jflitton/the-c128-keyboard-project/pcb/bom.csv

Reference | Qty | Value | DNP | Exclude from BOM | Exclude from Board | Footprint | Datasheet
C1,C2,C3 | 3 | 220 pF |  |  |  | Capacitor_SMD:C_0603_1608Metric_Pad1.08x0.95mm_HandSolder | ~
R1,R2,R3 | 3 | 330 |  |  |  | Resistor_SMD:R_0603_1608Metric_Pad0.98x0.95mm_HandSolder | ~
U1,U2,U3 | 3 | MAX16054 |  |  |  | Package_TO_SOT_SMD:TSOT-23-6 | https://datasheets.maximintegrated.com/en/ds/MAX16054.pdf
U4 | 1 | 74AUC1G66 |  |  |  | Package_SO:TSOP-5_1.65x3.05mm_P0.95mm | http://www.ti.com/lit/ds/symlink/sn74auc1g66.pdf
