jflitton/the-c128-keyboard-project/plate/plate.step

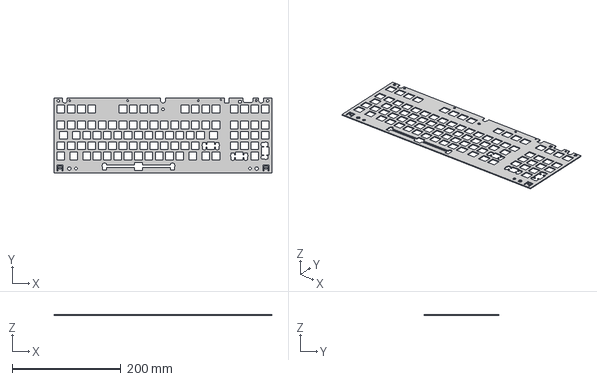
[picture p1: CAD file, 2025-11-16]
plate/plate.step
401.5 x 137.8 x 1.50 mm
