jflitton/the-c128-keyboard-project/printable_parts/128D/adapter_mitsumi_costar_spacebar_to_cherry_stabilizer.stl

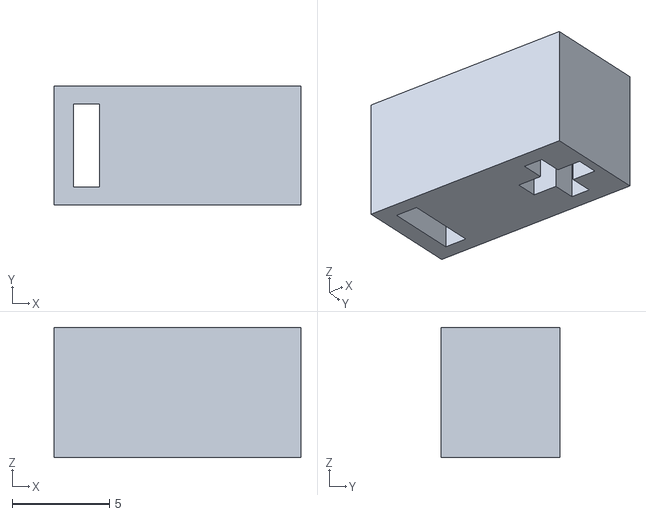
[picture p2: CAD file, 2025-11-24]
printable_parts/128D/adapter_mitsumi_costar_spacebar_to_cherry_stabilizer.stl
12.7 x 6.10 x 6.70
