jflitton/the-c128-keyboard-project/printable_parts/adapter_mitsumi_spacebar_to_cherry_stabilizer.stl

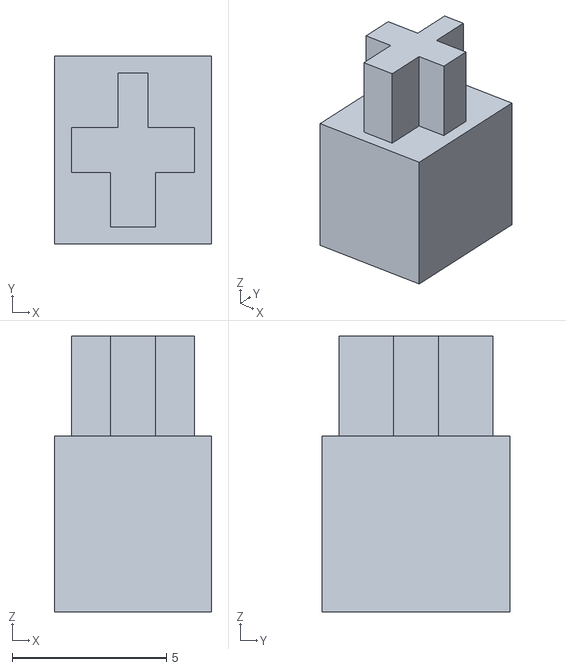
[picture p3: CAD file, 2025-11-17]
printable_parts/adapter_mitsumi_spacebar_to_cherry_stabilizer.stl
5.10 x 6.10 x 8.95
