jflitton/the-c128-keyboard-project/printable_parts/spacers_external_enclosure.stl

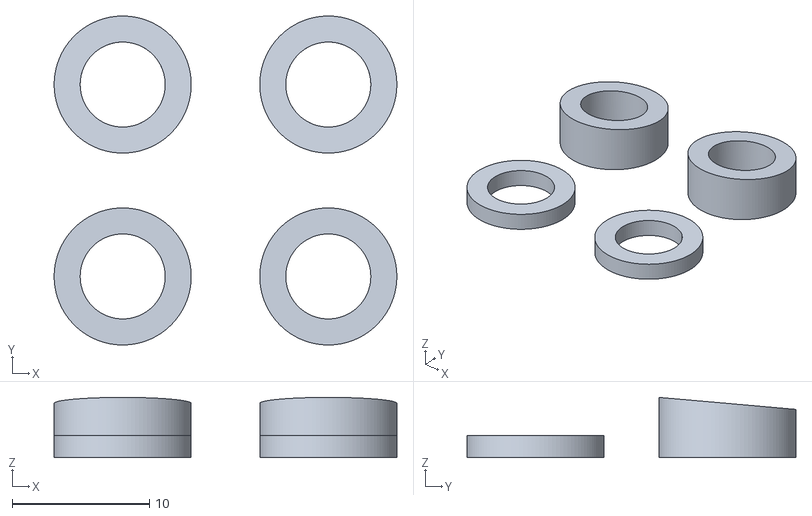
[picture p4: CAD file, 2025-11-16]
printable_parts/spacers_external_enclosure.stl
25.0 x 24.0 x 4.39
