jflitton/the-c128-keyboard-project/printable_parts/widget_foam_cutter_handle.stl

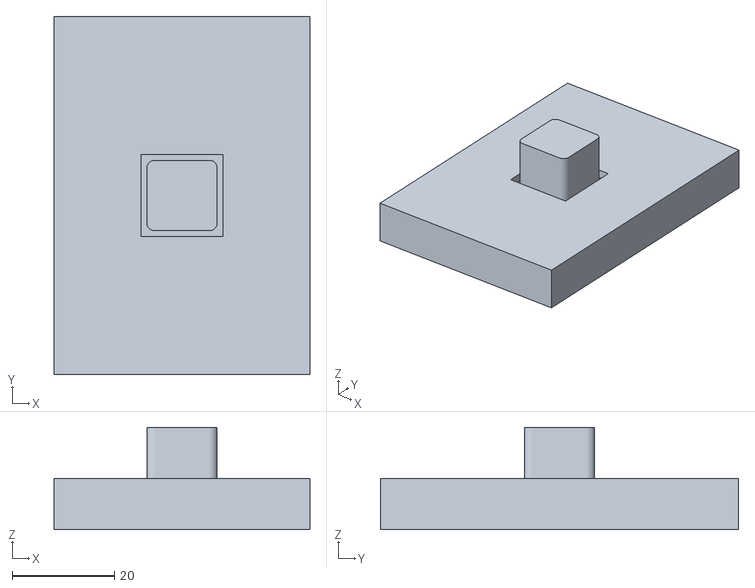
[picture p5: CAD file, 2025-11-09]
printable_parts/widget_foam_cutter_handle.stl
50.0 x 70.0 x 20.0
