jflitton/the-c128-keyboard-project/printable_parts/connector_motherboard_side.stl

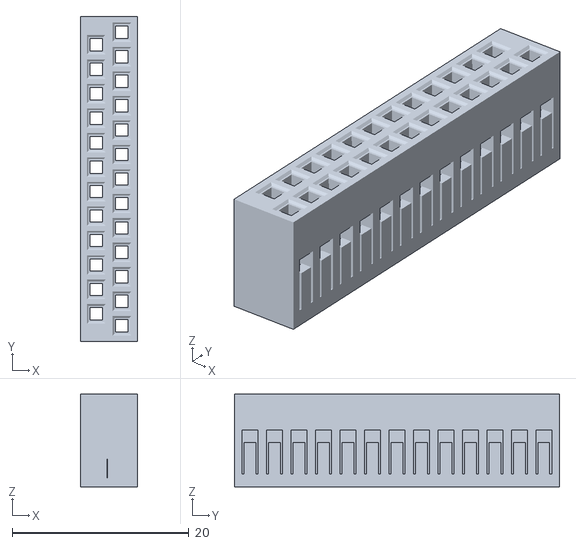
[picture p6: CAD file, 2025-11-09]
printable_parts/connector_motherboard_side.stl
6.40 x 36.8 x 10.5
