jflitton/the-c128-keyboard-project/printable_parts/shim_keyswitch.stl

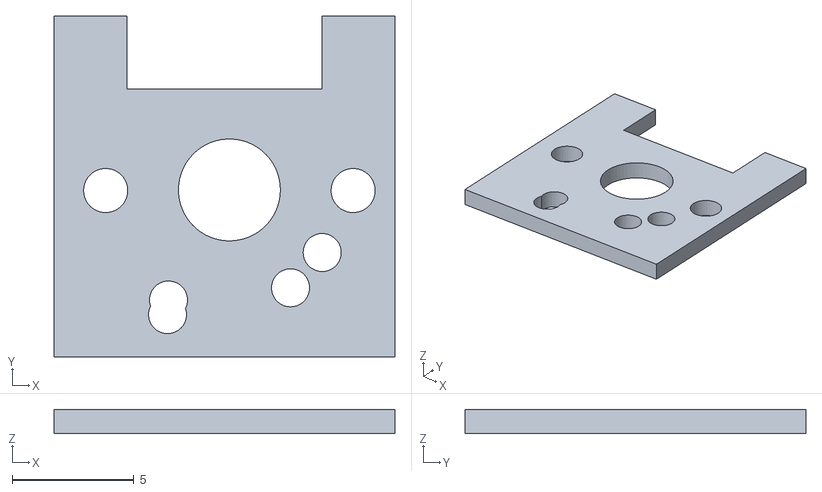
[picture p7: CAD file, 2025-11-09]
printable_parts/shim_keyswitch.stl
14.0 x 14.0 x 1.00
