jflitton/the-c128-keyboard-project/printable_parts/adapter_mitsumi_2u_stabilized_keycap_to_cherry_stabilizer.stl

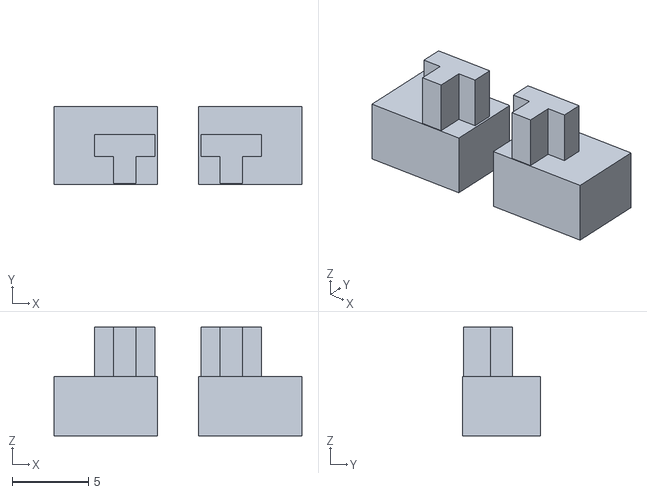
[picture p8: CAD file, 2025-11-09]
printable_parts/adapter_mitsumi_2u_stabilized_keycap_to_cherry_stabilizer.stl
16.3 x 5.10 x 7.15
