jflitton/the-c128-keyboard-project/printable_parts/adapter_mitsumi_regular_keycap_to_medium_low_cherry_switch.stl

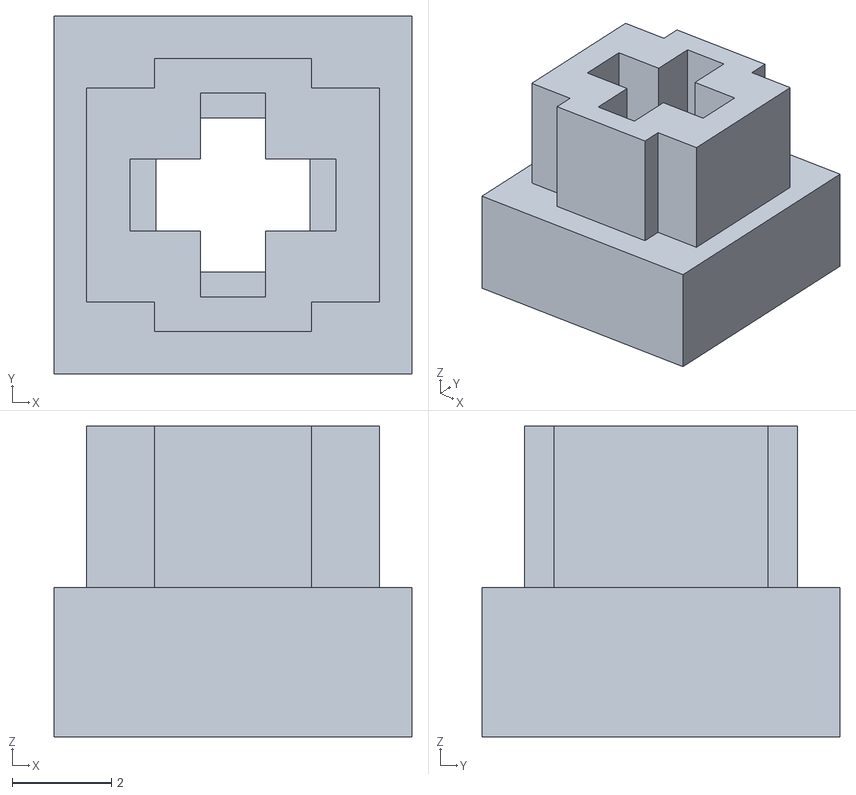
[picture p9: CAD file, 2025-10-14]
printable_parts/adapter_mitsumi_regular_keycap_to_medium_low_cherry_switch.stl
7.20 x 7.20 x 6.25
