jflitton/the-c128-keyboard-project/printable_parts/connector_keyboard_side.stl

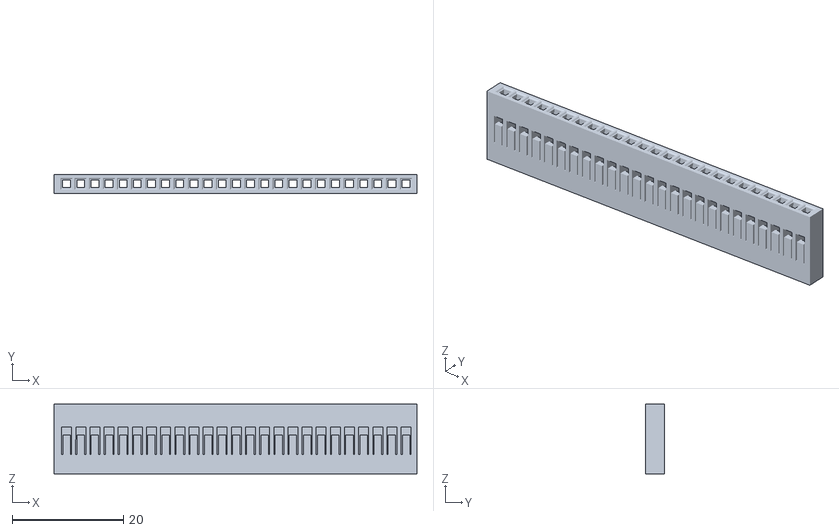
[picture p11: CAD file, 2025-10-14]
printable_parts/connector_keyboard_side.stl
65.2 x 3.40 x 12.5
