jflitton/the-c128-keyboard-project/(list of files, cad)

Other CAD files:
plate/plate.f3d
printable_parts/128D/adapter_mitsumi_costar_spacebar_to_cherry_stabilizer.f3d
printable_parts/adapter_mitsumi_2u_stabilized_keycap_to_cherry_stabilizer.f3d
printable_parts/adapter_mitsumi_function_keycap_to_medium_low_cherry_switch.f3d
printable_parts/adapter_mitsumi_regular_keycap_to_medium_low_cherry_switch.f3d
printable_parts/adapter_mitsumi_spacebar_to_cherry_stabilizer.f3d
printable_parts/connector_keyboard_side.f3d
printable_parts/connector_motherboard_side.f3d
printable_parts/shim_keyswitch.f3d
printable_parts/spacers_external_enclosure.f3d
printable_parts/widget_foam_cutter_handle.f3d
