jflitton/the-c128-keyboard-project/pcb/C128-keyboard.kicad_pcb

## KiCad design pcb/C128-keyboard.kicad_pcb (2025-11-16)

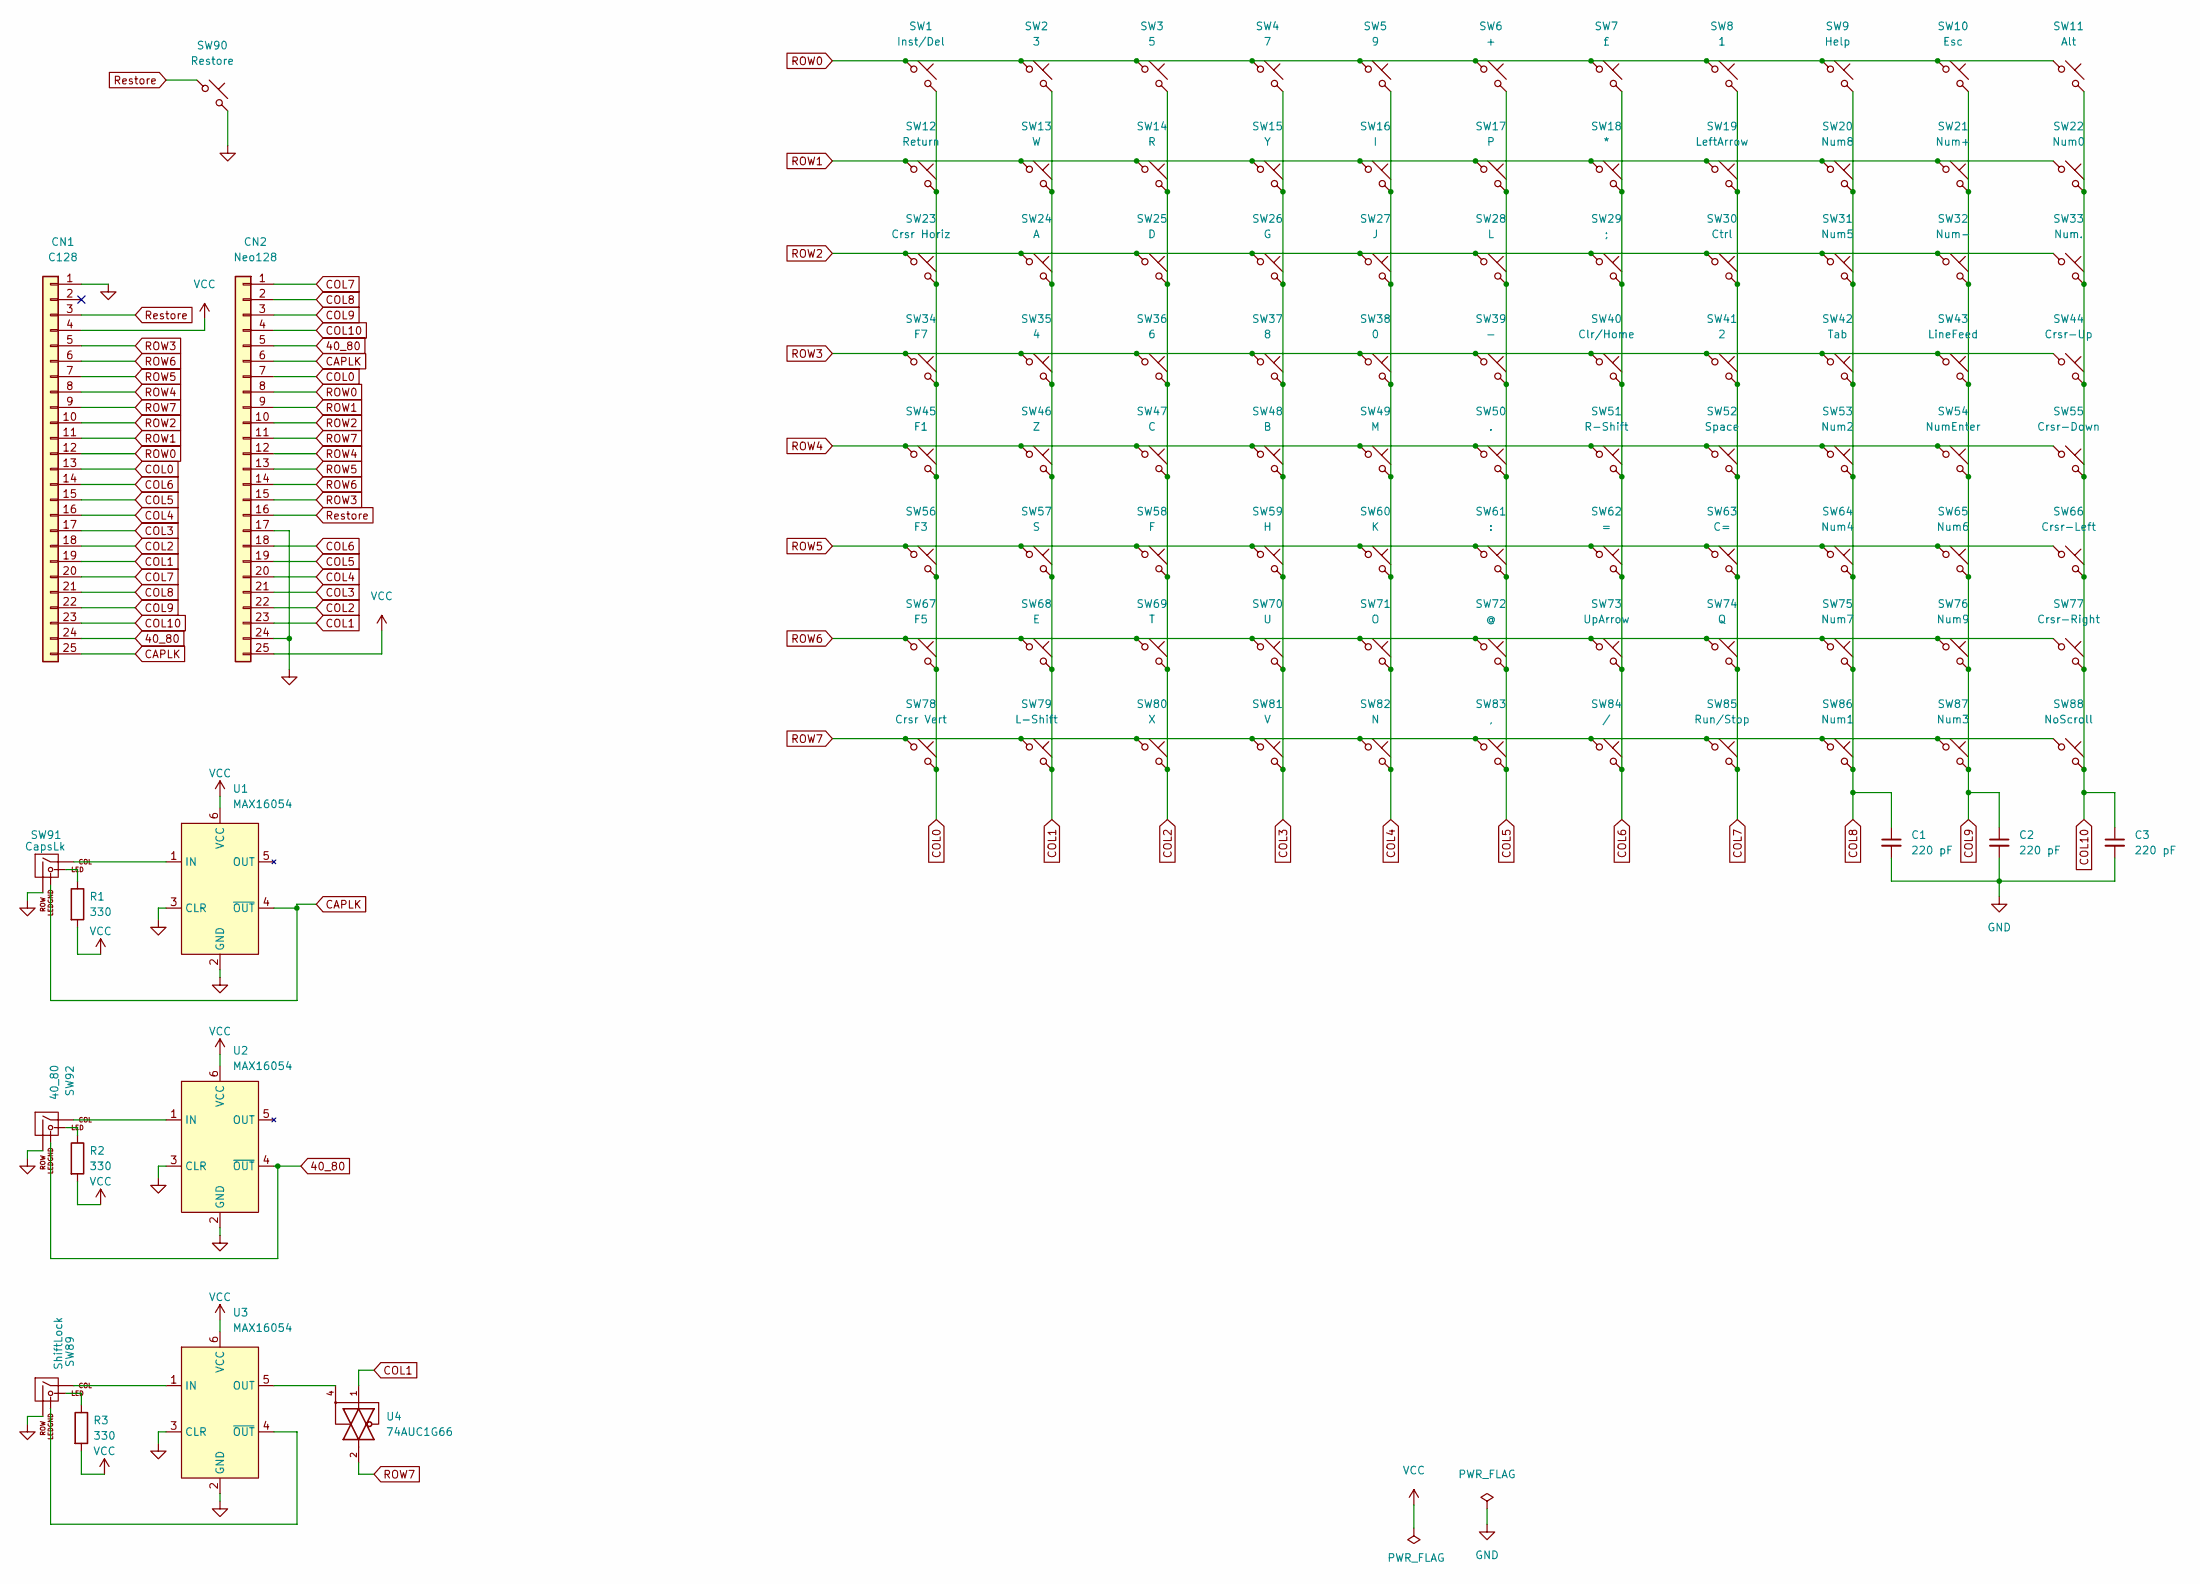
[picture p12: schematic C128-keyboard.kicad_sch]

Parts:
C1, C2, C3: 220 pF; C_0603_1608Metric_Pad1.08x0.95mm_HandSolder; LCSC C126556
CN1: C128
CN2: Neo128; PinHeader_1x25_P2.54mm_Vertical
R1, R2, R3: 330; R_0603_1608Metric_Pad0.98x0.95mm_HandSolder; LCSC C278617
SW1: Inst/Del; MX-1U-NoLED
SW2: 3; MX-1U-NoLED
SW3: 5; MX-1U-NoLED
SW4: 7; MX-1U-NoLED
SW5: 9; MX-1U-NoLED
SW6: +; MX-1U-NoLED
SW7: £; MX-1U-NoLED
SW8: 1; MX-1U-NoLED
SW9: Help; MX-1U-NoLED
SW10: Esc; MX-1U-NoLED
SW11: Alt; MX-1U-NoLED
SW12: Return; MX-2U-NoLED
SW13: W; MX-1U-NoLED
SW14: R; MX-1U-NoLED
SW15: Y; MX-1U-NoLED
SW16: I; MX-1U-NoLED
SW17: P; MX-1U-NoLED
SW18: *; MX-1U-NoLED
SW19: LeftArrow; MX-1U-NoLED
SW20: Num8; MX-1U-NoLED
SW21: Num+; MX-1U-NoLED
SW22: Num0; MX-2U-NoLED
SW23: Crsr Horiz; MX-1U-NoLED
SW24: A; MX-1U-NoLED
SW25: D; MX-1U-NoLED
SW26: G; MX-1U-NoLED
SW27: J; MX-1U-NoLED
SW28: L; MX-1U-NoLED
SW29: ;; MX-1U-NoLED
SW30: Ctrl; MX-1U-NoLED
SW31: Num5; MX-1U-NoLED
SW32: Num-; MX-1U-NoLED
SW33: Num.; MX-1U-NoLED
SW34: F7; MX-1U-NoLED
SW35: 4; MX-1U-NoLED
SW36: 6; MX-1U-NoLED
SW37: 8; MX-1U-NoLED
SW38: 0; MX-1U-NoLED
SW39: -; MX-1U-NoLED
SW40: Clr/Home; MX-1U-NoLED
SW41: 2; MX-1U-NoLED
SW42: Tab; MX-1U-NoLED
SW43: LineFeed; MX-1U-NoLED
SW44: Crsr-Up; MX-1U-NoLED
SW45: F1; MX-1U-NoLED
SW46: Z; MX-1U-NoLED
SW47: C; MX-1U-NoLED
SW48: B; MX-1U-NoLED
SW49: M; MX-1U-NoLED
SW50: .; MX-1U-NoLED
SW51: R-Shift; MX-1U-NoLED
SW52: Space; MX-7_9U-ReversedStabilizers-NoLED
SW53: Num2; MX-1U-NoLED
SW54: NumEnter; MX-2U-FLIPPED
SW55: Crsr-Down; MX-1U-NoLED
SW56: F3; MX-1U-NoLED
SW57: S; MX-1U-NoLED
SW58: F; MX-1U-NoLED
SW59: H; MX-1U-NoLED
SW60: K; MX-1U-NoLED
SW61: :; MX-1U-NoLED
SW62: =; MX-1U-NoLED
SW63: C=; MX-1U-NoLED
SW64: Num4; MX-1U-NoLED
SW65: Num6; MX-1U-NoLED
SW66: Crsr-Left; MX-1U-NoLED
SW67: F5; MX-1U-NoLED
SW68: E; MX-1U-NoLED
SW69: T; MX-1U-NoLED
SW70: U; MX-1U-NoLED
SW71: O; MX-1U-NoLED
SW72: @; MX-1U-NoLED
SW73: UpArrow; MX-1U-NoLED
SW74: Q; MX-1U-NoLED
SW75: Num7; MX-1U-NoLED
SW76: Num9; MX-1U-NoLED
SW77: Crsr-Right; MX-1U-NoLED
SW78: Crsr Vert; MX-1U-NoLED
SW79: L-Shift; MX-1.5U-NoLED
SW80: X; MX-1U-NoLED
SW81: V; MX-1U-NoLED
SW82: N; MX-1U-NoLED
SW83: ,; MX-1U-NoLED
SW84: /; MX-1U-NoLED
SW85: Run/Stop; MX-1U-NoLED
SW86: Num1; MX-1U-NoLED
SW87: Num3; MX-1U-NoLED
SW88: NoScroll; MX-1U-NoLED
SW89: ShiftLock; MX-1U
SW90: Restore; MX-1.5U-NoLED
SW91: CapsLk; MX-1U
SW92: 40_80; MX-1U
U1, U2, U3: MAX16054; TSOT-23-6
U4: 74AUC1G66; TSOP-5_1.65x3.05mm_P0.95mm; LCSC C327492

Connections:
40_80: CN1.24, CN2.5, SW92.4 (LEDGND), U2.4 (~OUT)
CAPLK: CN1.25, CN2.6, SW91.4 (LEDGND), U1.4 (~OUT)
COL0: CN1.13, CN2.7, SW1.2, SW12.2, SW23.2, SW34.2, SW45.2, SW56.2, SW67.2, SW78.2
COL1: CN1.19, CN2.23, SW2.2, SW13.2, SW24.2, SW35.2, SW46.2, SW57.2, SW68.2, SW79.2, U4.1
COL2: CN1.18, CN2.22, SW3.2, SW14.2, SW25.2, SW36.2, SW47.2, SW58.2, SW69.2, SW80.2
COL3: CN1.17, CN2.21, SW4.2, SW15.2, SW26.2, SW37.2, SW48.2, SW59.2, SW70.2, SW81.2
COL4: CN1.16, CN2.20, SW5.2, SW16.2, SW27.2, SW38.2, SW49.2, SW60.2, SW71.2, SW82.2
COL5: CN1.15, CN2.19, SW6.2, SW17.2, SW28.2, SW39.2, SW50.2, SW61.2, SW72.2, SW83.2
COL6: CN1.14, CN2.18, SW7.2, SW18.2, SW29.2, SW40.2, SW51.2, SW62.2, SW73.2, SW84.2
COL7: CN1.20, CN2.1, SW8.2, SW19.2, SW30.2, SW41.2, SW52.2, SW63.2, SW74.2, SW85.2
COL8: C1.1, CN1.21, CN2.2, SW9.2, SW20.2, SW31.2, SW42.2, SW53.2, SW64.2, SW75.2, SW86.2
COL9: C2.1, CN1.22, CN2.3, SW10.2, SW21.2, SW32.2, SW43.2, SW54.2, SW65.2, SW76.2, SW87.2
COL10: C3.1, CN1.23, CN2.4, SW11.2, SW22.2, SW33.2, SW44.2, SW55.2, SW66.2, SW77.2, SW88.2
GND: C1.2, C2.2, C3.2, CN1.1, CN2.17, CN2.24, SW89.2 (ROW), SW90.2, SW91.2 (ROW), SW92.2 (ROW), U1.2 (GND), U1.3 (CLR), U2.2 (GND), U2.3 (CLR), U3.2 (GND), U3.3 (CLR), U4.3 (GND)
unnamed: R1.1, SW91.3 (LED)
unnamed: R2.1, SW92.3 (LED)
unnamed: R3.1, SW89.3 (LED)
unnamed: SW89.1 (COL), U3.1 (IN)
unnamed: SW89.4 (LEDGND), U3.4 (~OUT)
unnamed: SW91.1 (COL), U1.1 (IN)
unnamed: SW92.1 (COL), U2.1 (IN)
unnamed: U3.5 (OUT), U4.4
ROW0: CN1.12, CN2.8, SW1.1, SW2.1, SW3.1, SW4.1, SW5.1, SW6.1, SW7.1, SW8.1, SW9.1, SW10.1, SW11.1
ROW1: CN1.11, CN2.9, SW12.1, SW13.1, SW14.1, SW15.1, SW16.1, SW17.1, SW18.1, SW19.1, SW20.1, SW21.1, SW22.1
ROW2: CN1.10, CN2.10, SW23.1, SW24.1, SW25.1, SW26.1, SW27.1, SW28.1, SW29.1, SW30.1, SW31.1, SW32.1, SW33.1
ROW3: CN1.5, CN2.15, SW34.1, SW35.1, SW36.1, SW37.1, SW38.1, SW39.1, SW40.1, SW41.1, SW42.1, SW43.1, SW44.1
ROW4: CN1.8, CN2.12, SW45.1, SW46.1, SW47.1, SW48.1, SW49.1, SW50.1, SW51.1, SW52.1, SW53.1, SW54.1, SW55.1
ROW5: CN1.7, CN2.13, SW56.1, SW57.1, SW58.1, SW59.1, SW60.1, SW61.1, SW62.1, SW63.1, SW64.1, SW65.1, SW66.1
ROW6: CN1.6, CN2.14, SW67.1, SW68.1, SW69.1, SW70.1, SW71.1, SW72.1, SW73.1, SW74.1, SW75.1, SW76.1, SW77.1
ROW7: CN1.9, CN2.11, SW78.1, SW79.1, SW80.1, SW81.1, SW82.1, SW83.1, SW84.1, SW85.1, SW86.1, SW87.1, SW88.1, U4.2
Restore: CN1.3, CN2.16, SW90.1
VCC: CN1.4, CN2.25, R1.2, R2.2, R3.2, U1.6 (VCC), U2.6 (VCC), U3.6 (VCC), U4.5 (VCC)

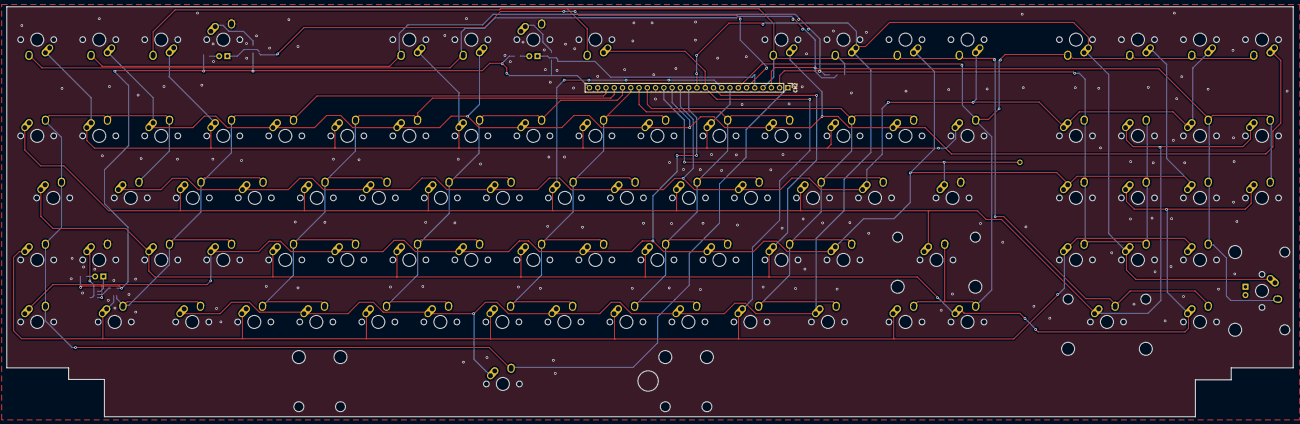
[picture p13: board C128-keyboard.kicad_pcb from above]

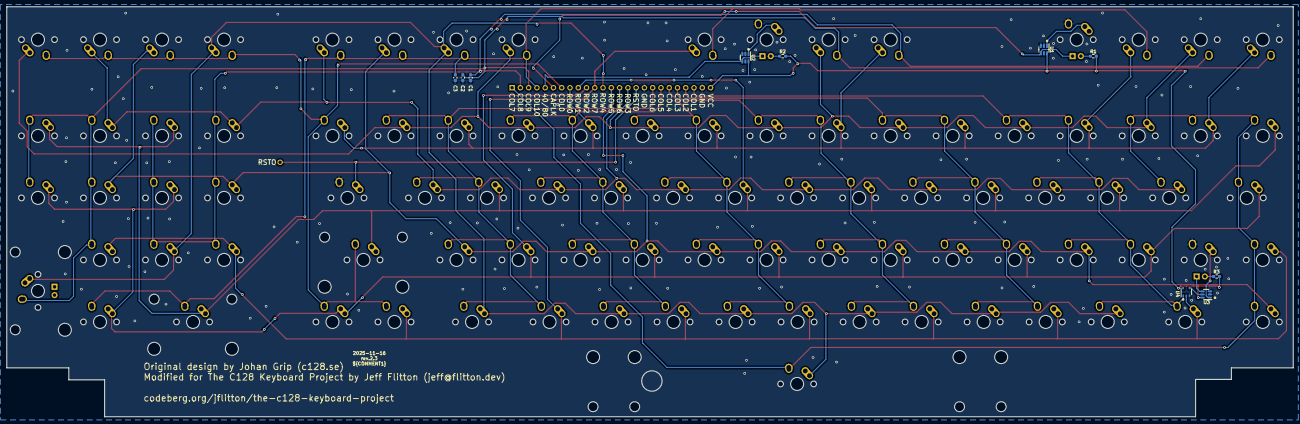
[picture p14: board C128-keyboard.kicad_pcb from below]

Board: 2 copper layers, 395.2 x 125.9 mm, 103 parts (10 on the bottom side), 32 nets.
