jflitton/the-c128-keyboard-project/(commit log)

2025-10-11 Initial import of PCB
    [C128-keyboard.kicad_pcb, C128-keyboard.kicad_sch]
2025-10-14 Wiring fixes for latch keys
    [C128-keyboard.kicad_pcb, C128-keyboard.kicad_sch]
2025-10-14 Plate v1.2
    [plate.f3d, plate.step]
2025-10-14 Adding printables
    [adapter_mitsumi_1u_stabilized_keycap_to_cherry_stabilizer.f3d, adapter_mitsumi_1u_stabilized_keycap_to_cherry_stabilizer.stl, adapter_mitsumi_function_keycap_to_medium_low_cherry_switch.f3d, adapter_mitsumi_function_keycap_to_medium_low_cherry_switch.stl, adapter_mitsumi_regular_keycap_to_medium_low_cherry_switch.f3d, adapter_mitsumi_regular_keycap_to_medium_low_cherry_switch.stl, connector_keybo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]
2025-10-14 Adding pad for plate grounding strap
    [C128-keyboard.kicad_pcb]
2025-10-14 CN2 labels and attribution
    [C128-keyboard.kicad_pcb]
2025-10-17 Moving stabilizers to align with c128 original spacebar
    [plate.f3d, plate.step]
2025-10-18 Stabilizer mounts aligned to stock C128 spacing
    [C128-keyboard.kicad_pcb]
2025-10-18 PCB 2.2 with extra restore pin
    [C128-keyboard.kicad_pcb]
2025-10-20 Edge cut cleanup
    [C128-keyboard.kicad_pcb]
2025-11-09 New plate model with params
    [adapter_mitsumi_2u_stabilized_keycap_to_cherry_stabilizer.f3d, adapter_mitsumi_2u_stabilized_keycap_to_cherry_stabilizer.stl, plate.f3d, plate.stl]
2025-11-09 moar printables
    [adapter_mitsumi_2u_stabilized_keycap_to_cherry_stabilizer.f3d, adapter_mitsumi_2u_stabilized_keycap_to_cherry_stabilizer.stl, adapter_mitsumi_function_keycap_to_medium_low_cherry_switch.f3d, adapter_mitsumi_regular_keycap_to_medium_low_cherry_switch.f3d, adapter_mitsumi_spacebar_to_cherry_stabilizer.f3d, adapter_mitsumi_spacebar_to_cherry_stabilizer.stl, shim_keyswitch.f3d, shim_keyswitch.stl]
2025-11-09 Minor plate fitment adjustments and shorter mb-side connector
    [connector_motherboard_side.f3d, connector_motherboard_side.stl, plate.f3d, plate.step, plate.stl, widget_foam_cutter_handle.f3d, widget_foam_cutter_handle.stl]
2025-11-14 Adding pin 1 indicators for ICs, no functional changes
    [C128-keyboard.kicad_pcb]
2025-11-16 Updating for 128DCR external enclosure
    [C128-keyboard.kicad_pcb, plate.f3d, plate.step, spacers_external_enclosure.f3d, spacers_external_enclosure.stl]
2025-11-17 Improved spacebar adapter
    [adapter_mitsumi_spacebar_to_cherry_stabilizer.f3d, adapter_mitsumi_spacebar_to_cherry_stabilizer.stl]
2025-11-17 Adjusting thickness
    [adapter_mitsumi_spacebar_to_cherry_stabilizer.f3d, adapter_mitsumi_spacebar_to_cherry_stabilizer.stl]
2025-11-24 128D spacebar stab adapter
    [adapter_mitsumi_costar_spacebar_to_cherry_stabilizer.f3d, adapter_mitsumi_costar_spacebar_to_cherry_stabilizer.stl]
2026-02-22 Adding BOM
    [bom.csv]
2026-02-22 Fixing BOM
    [bom.csv]
2026-02-22 New BOM
    [bom.csv]
